iw1qlh/CwTrainer/docs/CwTrainer.pdf

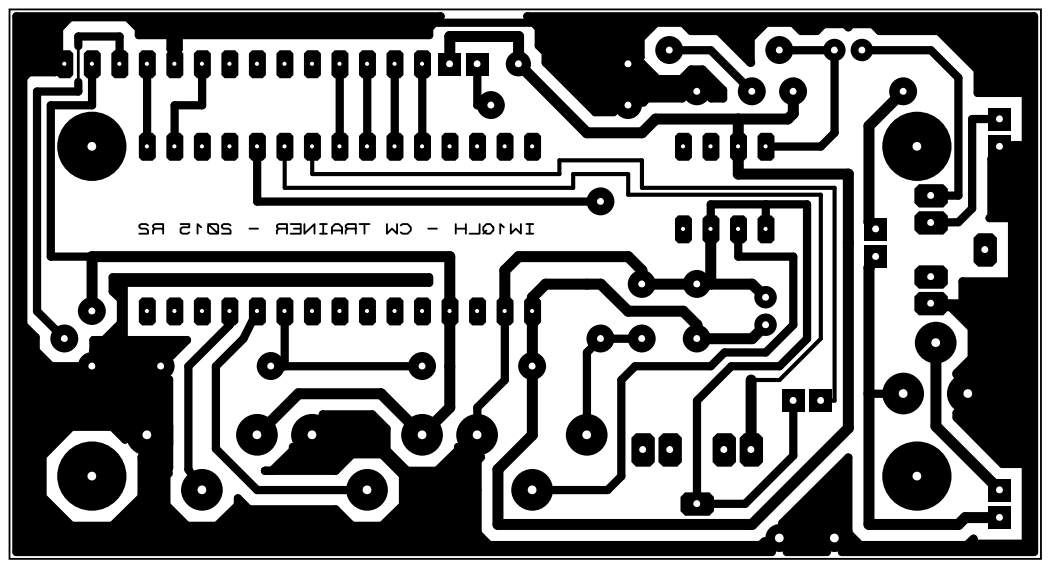
[picture p5: page 1]
