iw1qlh/CwTrainer/docs/dima-teko362.pdf

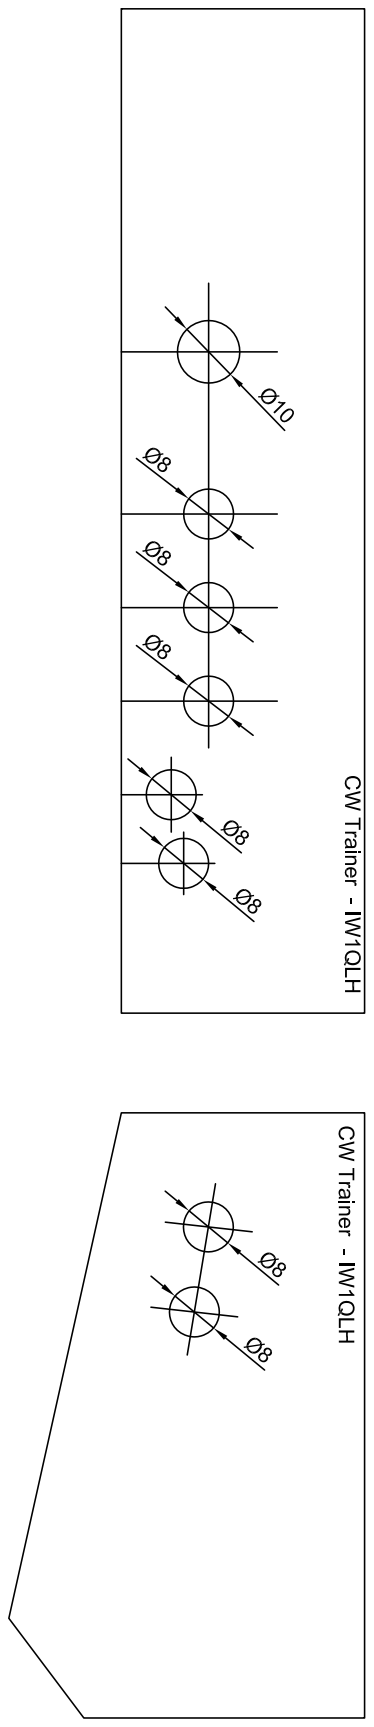
[picture p6: page 1]
