iw1qlh/CwTrainer/docs/maschera-teko362.pdf

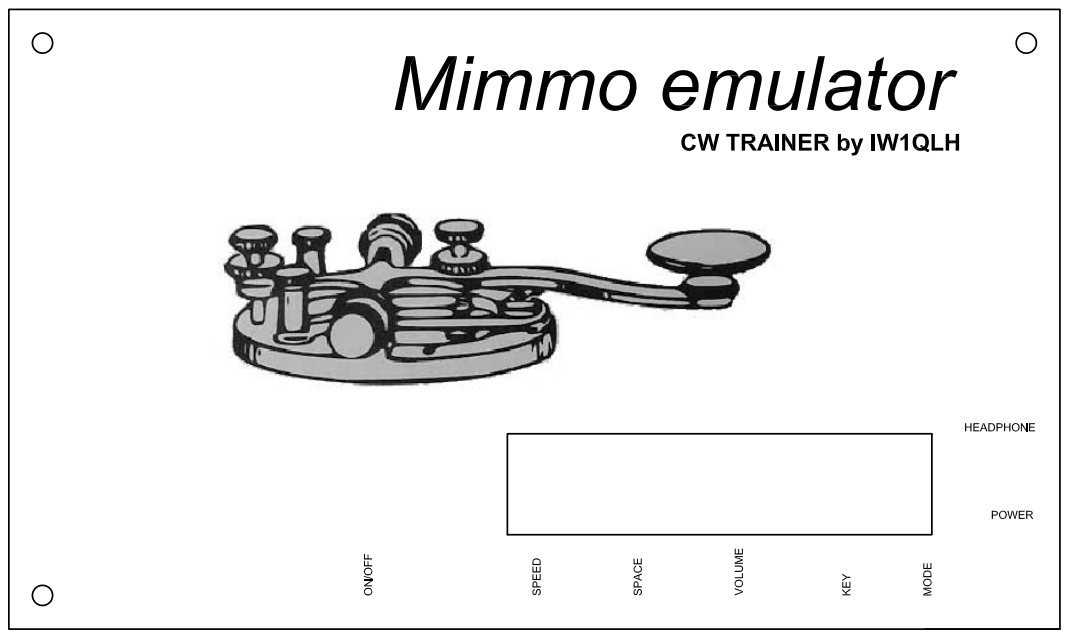
[picture p7: page 1]
